aksentyev/tmx-ainalyzer/README.md

# tmx analyzer

DIY-анализатор тримикса для дайвинга: **O2, He, CO2, CO** в одном приборе.
He измеряется акустически — по резонансной частоте закрытой трубки (скорость звука в смеси),
без расходного He-датчика. Мозги — ESP32-C5 на ESP-IDF.

## Статус (2026-10-20)

| Что | Состояние |
|---|---|
| Архитектура, физика, выбор датчиков | решено, см. `docs/decisions.md` |
| Принципиальная схема, распиновка C5, BOM | готово, проверено ревью по даташитам |
| Печатные детали (OpenSCAD) | смоделированы, проверены ревью; ждут замеров реальных модулей |
| Закупка | список готов (`docs/hardware/shopping-list.md`), **ничего не куплено** |
| Прошивка | не начата; требования собраны в `docs/firmware/notes.md` |
| Python-модель смеси (`tools/gasmodel`) | не начата |
| Корпус | печатный лоток v1 на термоклее — решено, не смоделирован |

Дальше: `docs/roadmap.md`.

## Карта репозитория

```
README.md                  ← вы здесь
CLAUDE.md                  правила работы с репо (для Claude и для людей)
docs/
  decisions.md             журнал решений с обоснованиями — почему именно так
  roadmap.md               этапы, что дальше, открытые вопросы
  hardware/
    v1.md                  блок-схема, пневматика, распиновка ESP32-C5, BOM, I2C-адреса
    schematic.md           принципиальная схема по листам, нетлист, бюджет тока, жгуты
    cell.md                акустическая ячейка: зачем так устроена
    layout.md              компоновка корпуса (зонирование) + layout-v1.svg/png
    shopping-list.md       список покупок в две волны
  firmware/
    notes.md               требования к прошивке, вытекшие из железа (I2S, SCD30, ZE15, Кирхгоф…)
hardware/
  scad/                    OpenSCAD-модели печатных деталей, params.scad, render.sh, README.md
  stl/                     (не коммитится) результат render.sh
```

## Ключевые числа

- Трубка Cu Ø25×1.5, L=180, пробки по 15 → L_ак ≈ 145.5 мм. f₁: воздух ≈1180 Гц, He ≈3460 Гц.
- Цель по He: 0.1 % абс. Чувствительность 5.5–12.5 Гц на 1 % He; T газа нужна с ±0.3 °C (0.171 %/°C).
- Пограничный слой Кирхгофа: до ~1 % He систематики без двухточечной калибровки (воздух + He).
- Калибровочные газы в наличии: воздух, Nx50, 100 % O2. He — достать.
- Бюджет железа v1 ≈ $340–420.

## Быстрый старт

```
brew install --cask openscad@snapshot      # стабильный cask отключён, снапшот ок
cd hardware/scad && ./render.sh            # STL + превью всех деталей
```

Перед печатью — пройти по пометкам **ИЗМЕРИТЬ** в `hardware/scad/params.scad`.
