aksentyev/tmx-ainalyzer/docs/hardware/schematic.md

# Принципиальная схема v1 (макет на модулях)

Схема по листам, как будет в KiCad. Все элементы — готовые breakout-модули на макетке/перфоплате,
дискретные компоненты — только обвязка между ними. Имена цепей (нетов) единые по всем листам
и в нетлисте в конце.

Соглашения:
- `+VBAT` — аккумулятор после защиты и выключателя (3.0–4.2 V)
- `+5V` — выход boost
- `+3V3` — выход нашего LDO (периферия). **Не** 3V3 девкита.
- `GND` — общая земля, одна точка звезды на перфоплате у LDO
- Пины девкита — `GPIOn`; пины модулей — по шелкографии модуля

---

## Лист 1 — Питание

```
                 F1 полифьюз 1.5 A
  18650 (+) ──────[====]──────┐
                               │  B+        TP4056 + DW01/FS8205          OUT+ ──┐
  18650 (−) ───────────────────┼─ B−        (модуль с USB-C)              OUT− ──┼─ GND
                               │            IN+/IN− ← USB-C зарядки              │
                               │                                                 │
                               │                        SW1 SPDT            ┌────┘
                               │                       ┌──o  o──── +VBAT ───┤
                               └───────────────────────┘                     │
                                                                             │
  +VBAT ──┬──────────────────────────────────────────────┐                   │
          │                                              │                   │
          │   U1 boost 5 V ≥1 A (MT3608, выставить        │  делитель АКБ:    │
          │      5.2 V — ZE15 требует ≥5.0 V)             │  +VBAT ─ R40 100k ─┬─ GPIO5 (ADC1_CH4)
          │   VIN ── +VBAT        VOUT ── +5V            │          R41 100k ─┤
          │   GND ── GND                                 │          C40 100 nF┤
          │                                              │                    GND
          │
  +5V ──┬─────────┬──────────────┬──────────────────┬───────────────────────────
        │         │              │                  │
        │   C1 220 µF/10 V    U2 AMS1117-3.3    D1 1N5819 ──► пин «5V» девкита
        │   (у MAX98357A)     IN ── +5V          (анод к +5V, катод к девкиту)
        │                     OUT ── +3V3
        │                     GND ── GND
        │                                  C2 100 µF/6.3 V  +3V3 ── GND  (у девкита/перфоплаты)
        │
        └── потребители 5 V: MAX98357A VIN, ZE15 Vin (через D2, лист 6)

  +3V3 потребители: SCD30, TMP117, BMP390, LCD ST7567, подтяжки I2C, лесенка кнопок

  Аналоговая шина (единственное аналоговое место прибора — 12 мВ ячейки на ADS1115):
  +5V ── R42 10 Ω ──┬── U3 LP5907-3.3 (или TPS7A20-3.3) ── +3V3A ── ADS1115 VDD, ICS-43434 VDD
                   C4 10 µF                     C5 1 µF (керамика, у U3)
  RC 10 Ω/10 µF: fc ≈ 1.6 кГц, на 1.2 МГц boost'а −57 dB; падение 0.2 V при 20 mA. Ферритовая бусина
  (600 Ω @ 100 МГц) на 1 МГц даёт лишь 20–50 Ω — здесь бесполезна. Дальше PSRR LP5907 (~40 dB @ 1 МГц,
  80 dB в звуке), шум 6.5 µV RMS — от boost и class-D на ADS1115 ничего не доходит.
  От +3V3 (AMS1117) питать нельзя — LDO нужен запас по входу, поэтому от +5V.
```

Пояснения:
- D1 развязывает нашу +5V с USB VBUS девкита. USB подключён → VBUS 5.0 V > 4.7 V за диодом →
  D1 закрыт, девкит ест USB, периферия — от АКБ. USB отключён → девкит от +5V через D1 (4.7 V на
  входе его LDO — достаточно для 3.3 V).
- Пин «3V3» девкита **ни с чем не соединять**, кроме как измерить.
- Земля — звездой на перфоплате у U2: силовая земля (boost, MAX98357A, ZE15) и земля датчиков
  (ADS1115, ячейка, микрофон) сходятся в одной точке; обратный ток усилителя не течёт через землю ячейки.
- TP4056 без load-sharing → заряжать выключенным (SW1 off).
- Бюджет тока — в конце документа.

---

## Лист 2 — MCU: ESP32-C5-DevKitC-1

Только используемые пины; остальные NC. Нумерация — GPIO, не номер пина гребёнки.

```
                     ┌──────────────────────────────┐
         +5V (за D1)─┤ 5V                       GND ├─ GND
                     │                              │
            SDA ─────┤ GPIO0                  GPIO2 ├───── UART_RX_ZE   (← ZE15 TXD, через R10)
            SCL ─────┤ GPIO1                  GPIO3 ├───── SPI_SCK
        ADC_BTN ─────┤ GPIO4                  GPIO5 ├───── (резерв, ADC1_CH4)
       I2S_BCLK ─────┤ GPIO6                  GPIO7 ├───── NC (JTAG strap)
   PAD_COMP0 рез.────┤ GPIO8                  GPIO9 ├───── PAD_COMP1 резерв
         I2S_WS ─────┤ GPIO10                GPIO11 ├───── UART_TX_ZE   (→ делитель → ZE15 RXD)
         LCD_BL ─────┤ GPIO12                GPIO13 ├───── USB D− (на плате)
                     │                       GPIO14 ├───── USB D+ (на плате)
     I2S_SD_MIC ─────┤ GPIO23                GPIO24 ├───── I2S_SD_AMP
       SPI_MOSI ─────┤ GPIO25                GPIO26 ├───── LCD_DC
        LCD_RST ─────┤ GPIO27                GPIO28 ├───── NC (BOOT)
                     │  USB-C: консоль/прошивка      │
                     └──────────────────────────────┘
```

Последовательные резисторы на I2S (R20–R22, 33 Ω) ставятся у девкита — см. лист 5.

---

## Лист 3 — Шина I2C и датчики на ней

```
  +3V3 ──┬── R1 4.7k ──┐
         └── R2 4.7k ──┼──┐
                       │  │
  GPIO0 ─── SDA ───────┴──┼────┬──────────┬──────────┬──────────┬──────────┐
  GPIO1 ─── SCL ──────────┴────┼────┬─────┼────┬─────┼────┬─────┼────┬─────┼────┐
                               │    │     │    │     │    │     │    │     │    │
                             SDA  SCL   SDA  SCL   SDA  SCL   SDA  SCL   SDA  SCL
                            ┌─────────┐┌─────────┐┌─────────┐┌─────────┐┌─────────┐
                            │ ADS1115 ││  SCD30  ││ TMP117  ││ BMP390  ││ резерв  │
                            │  0x48   ││  0x61   ││  0x49   ││  0x77   ││(ADS1220)│
                            └─────────┘└─────────┘└─────────┘└─────────┘└─────────┘
   питание:                  +3V3A/GND  +3V3/GND   +3V3/GND   +3V3/GND   —
   конфиг:                   ADDR→GND   SEL→GND    ADD0→V+    SDO откр.  —
                             ALERT NC   RDY NC     ALERT NC   CS откр.
                                        PWM NC                (I2C по умолч.)
```

- Скорость шины **100 кГц** (ограничение SCD30), clock stretching включён, таймаут ≥20 мс.
- Подтяжки: перед установкой R1/R2 посчитать, что уже стоит на модулях (ADS1115-модуль обычно
  10k, TMP117/BMP390 брейкауты — 10k). Цель: суммарно 2.2–4.7k.
  Если на модулях набирается ≥3 × 10k, R1/R2 не ставить.
- SCD30 — **опция** (decisions D17); если ставим — на отдельном JST-PH 4, кабель ≤15 см. Без него
  шина свободна от ограничений 100 кГц / clock stretching / no repeated start.
- TMP117 — в пробке B ячейки, кабель 4 жилы ≤15 см, JST-PH 4.
- BMP390 — в камере O2-ячейки.

---

## Лист 4 — O2: гальваническая ячейка → ADS1115

```
   O2-ячейка (R-22D / PSR-11-39-MD, внутри уже нагрузочный резистор и термокомпенсация)
   разъём: JST-PH 2 (на ячейке — Molex, переходник)

     (+) ──── R3 470 Ω ────┬──── AIN0 ┐
                           │          │  ADS1115, PGA ±256 mV (gain 16), диф. AIN0−AIN1
                        C3 220 nF     │  128 SPS, непрерывный режим
                        C0G/плёнка    │
                           │          │
     (−) ──┬─ R4 470 Ω ────┴──── AIN1 ┘
           │
          GND                       AIN2, AIN3 — NC (или резерв под вторую ячейку)
```

- Ячейка даёт +7…+14 mV в воздухе, ~+50…+65 mV в 100 % O2 → в ±256 mV с запасом, LSB 7.8 µV →
  ~0.07 % O2 на отсчёт, с шумом ±2–3 LSB ≈ 0.1–0.2 % без усреднения; усреднение 1 с → 0.05 %.
  Апгрейд — ADS1220 (24 бит, PGA 128): 0.01 %, тот же I2C-разъём. Питание — +3V3A.
- Минус ячейки на GND задаёт синфазный уровень; измерение дифференциальное, чтобы не ловить
  падение на земляных проводах.
- fc фильтра ≈ 770 Гц; суммарно 940 Ω последовательно при входном импедансе 710 kΩ → ошибка
  усиления 0.13 %, уходит в калибровку.
- **Ничего параллельно ячейке не вешать** — нагрузка уже внутри.

---

## Лист 5 — Акустика: I2S full-duplex

```
                       R20 33 Ω
  GPIO6  I2S_BCLK ────[===]────┬──────────────────────────► SCK   ICS-43434 (пробка B)
                               └──────────────────────────► BCLK  MAX98357A
                       R21 33 Ω
  GPIO10 I2S_WS ──────[===]────┬──────────────────────────► WS    ICS-43434
                               └──────────────────────────► LRC   MAX98357A

  GPIO23 I2S_SD_MIC ◄──────────────────────────────────────  SD    ICS-43434
                       R22 33 Ω
  GPIO24 I2S_SD_AMP ──[===]───────────────────────────────►  DIN   MAX98357A

  ICS-43434:  VDD ── +3V3A  GND ── GND   L/R ── GND (левый слот)
              кабель 5 жил ≤15 см, JST-PH 5, витая с GND

  MAX98357A:  VIN ── +5V (C1 220 µF рядом)   GND ── GND
              GAIN ── R23 100k ── VIN   (3 dB; без R23 = 9 dB)
              SD   ── R24 1 MΩ ── VIN   (режим (L+R)/2; на Adafruit-модуле уже стоит)
              +  ── SPK+ ───► динамик Ø20 8 Ω (пробка A), кабель 2 жилы ~25 см, JST-PH 2
              −  ── SPK−
```

- R20–R22 гасят звон на проводах при BCLK 3.072 МГц; ставить у девкита.
- 48 кГц / 32 бит, TX и RX на одном порту (`i2s_new_channel()` с обоими хэндлами).
- Усилитель на +5V — ради запаса по амплитуде; но в прошивке −6 dB, чтобы не спалить динамик.

---

## Лист 6 — CO: ZE15-CO (UART)

Распиновка по даташиту ZE15-CO (2023, 15-pin), совпадает с ZE15: PIN15 Vin 5–12 V; PIN5, PIN14 GND;
PIN7 RXD (0–3.0 V); PIN8 TXD (0–3.0 V); PIN10 DAC 0.4–2 V (не используем); PIN1 — выход 3.0 V
(не используем); **PIN3 — «неисправность сенсора», меандр 1 Гц 10 %** — опционально на свободный
GPIO (12 при BL на +3V3). Прогрев 30 с, отклик ≤30 с (у ZE15 было 3 мин / 60 с).
**Сверить с шелкографией конкретного модуля перед пайкой.**

```
                       D2 1N5819
  +5V ────────────────►|───────── PIN15 Vin        (защита от переполюсовки — своей у ZE15 нет)
                                  PIN5  GND ── GND
                                  PIN14 GND ── GND

                  R11 1k
  GPIO11 UART_TX_ZE ──[===]───┬── PIN7 RXD          V = 3.3·4.7/5.7 = 2.72 V  (вход 0–3.0 V)
                              │
                           R12 4.7k
                              │
                             GND

                  R10 1k
  GPIO2  UART_RX_ZE ◄─[===]────── PIN8 TXD          3.0 V → VIH ESP 2.48 V, ок
```

- 9600 8N1. По умолчанию active upload раз в секунду; при старте переводим в Q&A
  (кадр `FF 01 78 41 00 00 00 00 46`), опрос `FF 01 86 00 00 00 00 00 79`. Протокол — в
  `docs/firmware/notes.md`.
- Vin 5 V минус 0.3 V на D2 = 4.7 V — в диапазоне 5–12 V? **Нет**, 4.7 < 5.0. Варианты:
  (а) Шоттки с малым падением (PMEG2010, ~0.2 V → 4.8 V, всё ещё ниже); (б) убрать D2 и
  защититься механически — ключевой разъём JST-XH; (в) питать ZE15 напрямую с +5V и поднять
  boost до 5.2 V. **Выбор v1: (б) + (в)** — boost выставить 5.2 V, D2 не ставить, разъём с ключом.
  MAX98357A и девкит 5.2 V переносят.

---

## Лист 7 — UI: дисплей и кнопки

```
  LCD ST7567 128×64, SPI 4-wire, трансфлективный (GMG12864-06D / ERC12864, 3.3 V)
      GND ── GND
      VCC ── +3V3
      SCL/SCK ── SPI_SCK   (GPIO3)
      SI/SDA  ── SPI_MOSI  (GPIO25)
      RSE/RST ── LCD_RST   (GPIO27)
      RS/A0   ── LCD_DC    (GPIO26)
      CS      ── GND       (единственный slave; если модуль не терпит — на свободный GPIO)
      LED+/BL ── R33 (по току подсветки модуля, обычно уже стоит) ── LCD_BL (GPIO12, PWM)
      LED−    ── GND
  Названия пинов у модулей гуляют (SCL/SCK, SI/SDA, RSE/RST, RS/A0) — сверять с шелкографией.
  Контраст (регистр EV) зависит от температуры — компенсировать по TMP117/BMP390.

  Кнопки, резисторная лесенка на ADC1_CH3:

  +3V3 ──┬── SW_A ──── 0 Ω ────┐
         ├── SW_B ─── R31 4.7k ─┤
         └── SW_C ─── R32 15k ──┤
                                ├──── GPIO4 ADC_BTN
                   R30 10k ─────┤
                   C30 100 nF ──┤
                               GND

  Уровни: A = 3.3 V (насыщение, норм), B = 2.24 V, C = 1.32 V, ничего = 0 V.
  Пороги в прошивке: >2.8 → A, 1.8–2.8 → B, 0.6–1.8 → C, <0.6 → нет.
  Одновременные нажатия не различаются — не нужны.
```

---

## Нетлист (под будущий KiCad)

| Цепь | Подключения |
|---|---|
| GND | все модули; минус АКБ через TP4056 B−/OUT−; ячейка O2 (−) через R4-узел; ZE15 PIN5, PIN14; LCD CS, LED−; ICS L/R; ADS1115 ADDR; SCD30 SEL; C1, C2, C3-узел, C30, R12, R30 |
| +VBAT | TP4056 OUT+ → SW1 → U1 VIN, R40 |
| VBAT_SENSE | R40/R41 узел; C40; GPIO5 |
| +3V3A | U3 OUT; C5; ADS1115 VDD; ICS-43434 VDD |
| +5V | U1 VOUT; C1; U2 IN; R42 → U3 IN (C4); D1 анод; MAX98357A VIN, R23, R24; ZE15 PIN15 (без D2, см. лист 6) |
| DEVKIT_5V | D1 катод → девкит «5V» |
| +3V3 | U2 OUT; C2; SCD30 VDD; TMP117 V+ и ADD0; BMP390 VIN; LCD VCC; R1, R2; SW_A/B/C |
| SDA | GPIO0; R1; ADS1115, SCD30, TMP117, BMP390 SDA |
| SCL | GPIO1; R2; те же SCL |
| O2_P | ячейка (+) → R3 |
| O2_N | ячейка (−) → R4; → GND |
| ADS_AIN0 | R3 → ADS1115 AIN0; C3 |
| ADS_AIN1 | R4 → ADS1115 AIN1; C3 |
| I2S_BCLK | GPIO6 → R20 → ICS SCK, MAX BCLK |
| I2S_WS | GPIO10 → R21 → ICS WS, MAX LRC |
| I2S_SD_MIC | ICS SD → GPIO23 |
| I2S_SD_AMP | GPIO24 → R22 → MAX DIN |
| SPK+, SPK− | MAX98357A +/− → динамик |
| UART_TX_ZE | GPIO11 → R11 → узел (R12→GND) → ZE15 PIN7 |
| UART_RX_ZE | ZE15 PIN8 → R10 → GPIO2 |
| SPI_SCK | GPIO3 → LCD SCK |
| SPI_MOSI | GPIO25 → LCD SI |
| LCD_DC | GPIO26 → LCD RS/A0 |
| LCD_RST | GPIO27 → LCD RST |
| LCD_BL | GPIO12 → LCD LED+ (через R33) |
| ADC_BTN | GPIO4; R30, C30; SW_A/0 Ω, SW_B/R31, SW_C/R32 |

## Перечень дискретных компонентов схемы

| Поз. | Номинал | Где |
|---|---|---|
| F1 | полифьюз 1.5 A hold | + АКБ |
| U3 | LP5907-3.3 / TPS7A20-3.3 (модуль или SOT-23 на переходнике) | аналоговая шина +3V3A |
| R42 | 10 Ω | +5V → U3, RC-фильтр |
| C4 | 10 µF керамика X7R | вход U3 |
| C5 | 1 µF керамика X7R | выход U3 |
| R40, R41 | 100k | делитель АКБ |
| C40 | 100 nF | узел делителя |
| SW1 | SPDT слайдер ≥1 A | +VBAT |
| D1 | 1N5819 | +5V → девкит 5V |
| C1 | 220 µF / 10 V электролит | +5V у MAX98357A |
| C2 | 100 µF / 6.3 V электролит | +3V3 у перфоплаты |
| C3 | 220 nF C0G/плёнка | ADS1115 AIN0–AIN1 |
| C30 | 100 nF | ADC_BTN |
| R1, R2 | 4.7k (по месту) | I2C подтяжки |
| R3, R4 | 470 Ω | фильтр O2 |
| R10, R11 | 1k | UART ZE15 |
| R12 | 4.7k | делитель на RXD ZE15 |
| R20–R22 | 33 Ω | I2S |
| R23 | 100k | MAX98357A GAIN (3 dB) |
| R24 | 1 MΩ | MAX98357A SD (если нет на модуле) |
| R30 | 10k | подтяжка лесенки вниз |
| R31 | 4.7k | SW_B |
| R32 | 15k | SW_C |
| SW_A–C | тактовые 12 мм | UI |

## Бюджет тока

| Потребитель | Шина | Типично | Пик |
|---|---|---|---|
| ESP32-C5 (BLE активен) | 5V девкита | 80–120 mA | 350 mA |
| LCD ST7567 (1 mA) + подсветка | +3V3 | 1–30 mA | 40 mA |
| SCD30 | +3V3 | 19 mA | 75 mA |
| ADS1115, TMP117, BMP390, ICS-43434 | +3V3/+3V3A | <5 mA | — |
| MAX98357A + динамик 20 мм (чирп, −6 dB) | +5V | 50 mA | 300 mA (импульс) |
| ZE15-CO | +5V | 5 mA | 10 mA |
| **Итого с +5V** (включая LDO) | | ~220 mA | ~730 mA |
| **Со стороны АКБ** (boost КПД 85 %, 3.7 V) | | ~400 mA | ~1.2 A |

18650 2500–3000 mAh → 5–7 ч непрерывной работы, с выключенной подсветкой больше. Полифьюз
1.5 A и boost ≥1 A — с запасом для пиков.

## Разъёмы и жгуты

| Жгут | Разъём | Жилы | Длина | Куда |
|---|---|---|---|---|
| Микрофон | JST-PH 5 | VDD, GND, SCK, WS, SD | ≤15 см | пробка B |
| TMP117 | JST-PH 4 | V+, GND, SDA, SCL | ≤15 см | пробка B |
| Динамик | JST-PH 2 | SPK+, SPK− | ~25 см | пробка A |
| O2-ячейка | JST-PH 2 (+ переходник на Molex ячейки) | +, − | ~10 см | камера O2 |
| BMP390 | JST-PH 4 | VIN, GND, SDA, SCL | ~10 см | камера O2 |
| SCD30 | JST-PH 4 (+ SEL на GND внутри колпака) | VDD, GND, SDA, SCL | ~10 см | колпак SCD30 |
| ZE15 | JST-XH 4 с ключом | Vin, GND, RXD, TXD | ~10 см | колпак ZE15 |
| Дисплей | 8-pin Dupont / пайка | GND, VCC, SCK, SI, RST, RS, CS, BL | ~8 см | крышка |
| Кнопки | 4 провода | +3V3, A, B, C | ~8 см | крышка |
| АКБ | XH 2 | +, − | | холдер |
