aksentyev/tmx-ainalyzer/docs/firmware/notes.md

# Заметки по прошивке (идеи до реализации)

## Критерий стабилизации показаний — по производной, а не по таймеру

Расход через ограничитель-отверстие ∝ давлению в баллоне (4× между 200 и 50 бар) и ~3× выше
для He, чем для воздуха. Время продувки плавает 10–40 с, поэтому фиксированный таймер не работает.

Правило: показание считается стабильным, когда за скользящее окно
- **He/O2 (5 с):** f резонанса ушла меньше чем на ~0.5 Гц, O2 — меньше 0.1 %, T газа — меньше 0.2 °C;
- **CO2 (30 с):** SCD30 имеет τ63 = 20 с — окно длиннее;
- **CO (30–45 с):** ZE15 отклик ≤30 с, прогрев 30 с (первое включение — 5 мин).

Чувствительность f к He зависит от состава: при L_ак = 150 мм ≈ 5.5 Гц/% He около 0 % He и
≈ 12.5 Гц/% около 50 % He. Так что 0.5 Гц — это 0.05–0.09 % He. O2 тоже двигает c:
≈ −1.1 Гц на 1 % O2 → расчёт He обязан брать O2 с ячейки (или ручной ввод, как у Divesoft).

UI показывает «стабилизация…» с индикатором тренда, потом фиксирует результат. Это ещё и
защита от «снял показания, пока гелий не доехал».

## LCD ST7567

Контраст (регистр electronic volume, 0–63) плывёт с температурой: на холоде бледнеет, на жаре
чернеет. Компенсировать линейно по T (TMP117/BMP390), коэффициент подобрать на модуле —
обычно −0.5…−1 единица EV на 10 °C. Подсветка — PWM на GPIO12, автогашение по таймауту и
по яркости снаружи не нужно: трансфлективный читается без подсветки на солнце.

## Консоль и UART

Консоль на USB-Serial/JTAG (`CONFIG_ESP_CONSOLE_USB_SERIAL_JTAG=y`), GPIO11/12 свободны от
консоли. ROM-бутлоадер всё равно печатает в U0TXD (GPIO11) при сбросе — ZE15 на нём битые
кадры игнорирует, но парсер ответов ZE15 должен быть терпим к мусору в первые ~0.5 с.
RX от ZE15 — на GPIO2, **не** на GPIO12 (U0RXD): в download-режиме ROM слушает UART0, а ZE15
в режиме active upload шлёт кадр каждую секунду и может сбить esptool.

## I2S full-duplex

Один контроллер, `i2s_new_channel()` с обоими хэндлами; общие BCLK/WS, одинаковые sample rate и
bits-per-frame у TX и RX. 48 кГц / 32 бит (ICS-43434 отдаёт 24 в 32-битном слоте; MAX98357A ест
16/24/32). DOUT — чирп/шум, DIN — микрофон.

**Оговорка IDF:** full-duplex «не гарантирует синхронной записи/чтения TX и RX, они только
делят клок». Дрейфа нет (один клок), но стартовое смещение между DMA TX и RX — целое число
сэмплов, не фиксированное между запусками. Для резонансного метода (ищем частоты пиков)
безразлично. Для ToF/корреляции (план Б) задержку надо мерить каждый запуск — электрической
петлёй DOUT→DIN или акустическим репером.

MAX98357A в режиме (L+R)/2 (SD_MODE через 1 MΩ): писать одинаковые сэмплы в оба слота, иначе
−6 dB. Амплитуду ограничить −6 dB цифрой (полная шкала при 5 V / 8 Ом ≈ 1.5 Вт — больше
номинала динамика).

## Полоса свипа и распознавание гребёнки

Не следить за одним пиком — свипить широко чирпом/шумом (~1 с), находить все пики, проверять
равный шаг Δf = c/2·L_ак и опознавать номер моды n.

Полоса — **0.5–20 кГц**, не 0.5–8: при L_ак = 150 мм в чистом He моды 3.36 / 6.72 / 10.07 кГц,
в полосе до 8 кГц только два пика, «равный шаг» не проверить. fs = 48 кГц позволяет; срез
MAX98357A 0.47·fs ≈ 22 кГц, ICS-43434 до 20 кГц. Q растёт как √f — высокие моды даже уже.

Поперечные моды: первая (1,0) в трубе Ø22 начинается с 0.586·c/d ≈ 9.1 кГц в воздухе, 13 кГц
в 50 % He, 27 кГц в чистом He. Выше отсечки гребёнка «засоряется». Два средства: микрофон в
центре торца сидит в узле моды (1,0) и почти её не видит; алгоритм ищет **наименьший**
согласованный шаг гребёнки, начиная снизу.

## Пики трубки vs горб динамика

У 20-мм динамика свой резонанс (по даташиту ~500 Гц, Q≈2; с задней камерой 2 мл он уедет к
1–2 кГц) — широкий горб в передаточной функции. Резонансы трубки узкие (Q≈40–80). Искать
пики относительно локального baseline (median filter по спектру), не по абсолютному уровню.

## Пограничный слой Кирхгофа — систематика, зависящая от газа

Термовязкий слой у стенок замедляет волну: Δc/c ≈ −k·(δ_v/R)·(1 + (γ−1)/√Pr), δ_v = √(2ν/ω),
k — коэффициент порядка 0.5–0.7 (теория Кирхгофа для широкой трубы; точное значение в нашей
геометрии уточняется калибровкой). Для R = 11 мм на f₁: воздух ≈ −0.4…−0.6 %, He (ν в 8× выше,
f в 3× выше) ≈ −0.9…−1.2 %. **Если откалибровать L_ак только по воздуху, в чистом He остаётся
≈ −0.5 % по c ≈ 1 % He абсолютной ошибки**, на 50 % He ≈ 0.7 % — выше цели 0.1 %.

Что делать:
1. Двухточечная калибровка: воздух + чистый He (или известный тримикс). Воздух фиксирует
   L_ак, He — коэффициент k.
2. В модели поправка считается из ν, Pr, γ **смеси** — итеративно: оценили состав → поправка →
   уточнили состав; сходится за 2–3 итерации.
3. Работать на высших модах, где поправка ∝ 1/√f меньше: для He брать f₂/f₃, не f₁.

## SCD30 — особенности интерфейса и измерения

- I2C **100 кГц максимум** — вся шина на 100 кГц. Требует clock stretching до 12 мс (раз в
  сутки до 150 мс) — таймаут в драйвере ≥20 мс, одиночные ошибки — ретрай.
- **Не поддерживает repeated start** — не `i2c_master_transmit_receive()`, а write → пауза ≥3 мс →
  read.
- VIH I2C по даташиту 1.75–3.0 V, подтяжки на 3.3 V формально вне спецификации — на практике
  работает, знать.
- ASC по умолчанию **выключен** — не включать никогда: он считает недельный минимум эталоном
  400 ppm, на чистых газах с 0 ppm CO2 уедет. Раз в несколько месяцев — FRC на воздухе (~420 ppm).
- Диапазон 400–10000 ppm, точность ±(30 ppm + 3 %). Порог EN 12021 (500 ppm) — у нижнего края
  с ±45 ppm; показания <400 ppm выдаёт, но вне спецификации. Компенсация давления 700–1200 мбар
  — брать с BMP390.
- **He-матрица**: NDIR зависит от уширения линий фоновым газом (He уширяет слабее N2 → занижение)
  и от теплопроводности (He в 6× выше → тепловой баланс источника/детектора). Количественных
  данных у Sensirion нет — проверять на известной смеси и вводить He-зависимую поправку.

## ZE15-CO

- UART 9600 8N1, 0–500 ppm, 0.1 ppm. Выход 3.0 V TTL, вход 0–3.0 V — на TX от ESP делитель.
- Прогрев 30 с (первое включение 5 мин), отклик ≤30 с, нельзя обдувать струёй — колпак
  диффузионный. Мешающий газ — спирт: не дышать на вход.
- Режим: при старте перевести в Q&A, чтобы не спамил. ZE15 **сам** возвращается в active upload,
  если долго нет запросов — опрашивать регулярно или терпеть кадры.
- PIN3 — выход неисправности сенсора (меандр 1 Гц, 10 %): если заведён на GPIO — считать
  фронты, при наличии показывать «CO sensor fault».

Протокол (одинаков у ZE07 v1.7 и ZE15 2023), кадры 9 байт, контрольная сумма = NOT(byte1+…+byte7) + 1:
- Active upload (раз в 1 с): `FF 04 03 01 HH LL FH FL CS` — CO = (HH·256+LL)·0.1 ppm,
  FH/FL — полная шкала (0x1388 = 5000 → 500 ppm).
- Переключить в Q&A: `FF 01 78 41 00 00 00 00 46`. Обратно в active: `FF 01 78 40 00 00 00 00 47`.
- Запрос в Q&A: `FF 01 86 00 00 00 00 00 79`; ответ: `FF 86 HH LL 00 00 FH FL CS`.
- Пины: 15 Vin (5–12 V), 5/14 GND, 7 RXD (0–3.0 V), 8 TXD, 10 DAC 0.4–2 V. Vin ≥5.0 V — boost на 5.2 V.
