aksentyev/tmx-ainalyzer/docs/hardware/layout.md

# Компоновка v1

Картинка: `layout-v1.svg` (вектор) / `layout-v1.png` — сгенерирована разово из этого файла,
при изменениях править SVG вручную или перерисовать.

Зонирование корпуса, газовый тракт, жгуты, тепловые зоны. Это план под CAD, а не финальные
размеры: всё с допусками ±5 мм, пока не померяны реальные модули.

## Корпус

Одноуровневая компоновка — проще собирать и отлаживать, чем в два этажа. Цена — размер.

- Внутренние размеры: **230 × 125 × 55 мм** (Д × Ш × В). v1 — печатный корпус из двух половин
  (основание + крышка-панель) PETG, или покупной ABS-бокс ближайшего размера с печатной панелью.
- Основание несёт трубку, камеры датчиков, АКБ, силовую электронику, перфоплату, девкит.
- Крышка — дисплей, кнопки.
- Торцевые стенки: слева — вход газа, выхлоп, USB-C зарядки, выключатель; спереди — USB-C девкита.

Длину задаёт ячейка: трубка 180 + фланцы 2×10 = 200 мм, **порты — печатные ёлочки на лагах
фланцев, радиально вперёд** (к центру корпуса), а не осевые — иначе +30 мм на фитинги.
Лаги выступают от края фланца на 15 мм (A) и 22 мм (B) к центру: у торца B они доходят до
Y≈71 — камера O2-ячейки в среднем ряду сдвигается левее/ниже, чтобы не упереться в лаг и
ёлочку. На картинке это пока не отражено — макет на термоклее, поправим по месту.

## Вид сверху (крышка снята), мм

```
 Y
 125 ┌────────────────────────────────────────────────────────────────────────────────┐
     │ ╔════╗                                                                   ╔════╗ │
     │ ║ A  ║═══════════════════ трубка Cu Ø25, L=180 ═══════════════════════════║ B  ║ │  задний ряд
  92 │ ║флан║  ~~~змеевик 6 вит.~~~            ось Y=108                        ║флан║ │  Y 92–125
     │ ╚═╤══╝ X 25–60                                                           ╚══╤═╝ │
     │   │порт A (вниз)                                                            │порт B
  88 ├───┼─────────────────────────────────────────────────────────────────────────┼────┤
     │   │                                                                         │    │
     │ ┌─┴──────────┐  ┌───────────────┐  ┌───────────────┐  ┌─────────────────────┴──┐ │
     │ │ ПИТАНИЕ    │  │ колпак ZE15   │  │ колпак SCD30  │  │ камера O2-ячейки       │ │  средний ряд
  48 │ │ TP4056     │  │ 40×35         │  │ 40×30         │  │ Ø36 × 65, горизонт.    │ │  Y 48–88
     │ │ boost, LDO │  │   ◄──────────────◄───────────────────◄── газ из порта B      │ │
     │ │ SW1        │  │ X 70–110      │  │ X 115–155     │  │ + BMP390 внутри        │ │
     │ └────────────┘  └───────┬───────┘  └───────────────┘  └────────────────────────┘ │
     │  X 10–60               │ выхлоп → левая стенка (Y≈44)                             │
  44 ├────────────────────────┼─────────────────────────────────────────────────────────┤
     │                        │                                                          │
     │ ┌──────────────────┐   │  ┌──────────────────────┐   ┌──────────────────────────┐ │
     │ │ 18650 холдер     │   │  │ ESP32-C5-DevKitC-1   │   │ перфоплата 60×40         │ │  передний ряд
   5 │ │ 78 × 21          │   │  │ 65 × 26, USB-C ─► ▼  │   │ ADS1115, LP5907,         │ │  Y 5–44
     │ │ X 5–85           │   │  │ X 90–160             │   │ MAX98357A, R/C-обвязка   │ │
     │ └──────────────────┘   │  └──────────────────────┘   │ X 165–225                │ │
     │                        │                              └──────────────────────────┘ │
   0 └────────────────────────┴──────────────────────────────────────────────────────────┘
     0        25        50        75       100       125       150       175       200   230  X
```

Левая торцевая стенка (X=0), снизу вверх: выключатель SW1 (Y≈15), USB-C зарядки TP4056 (Y≈30),
**выхлоп** — ёлочка сквозь стенку (Y≈44, на границе среднего и переднего рядов), **вход газа** — ёлочка (Y≈108, напротив змеевика).
Передняя стенка (Y=0): окно под USB-C девкита (X≈125).

Крышка (вид сверху, совпадает по X):
- LCD 128×64 ST7567 (модуль ~55 × 42, померить) над девкитом, X 97–152, Y 5–47 — шлейф 8 см вниз
  к девкиту. Трансфлективный: на солнце подсветку гасить.
- Три кнопки Ø12 над перфоплатой, X 170 / 195 / 220, Y 12 (ниже надписей перфоплаты).
- Над трубкой и датчиками крышка глухая.

## Вид сбоку (сечение по Y=108, трубка), мм

```
 Z
 55 ┌──────────────────────── крышка ───────────────────────────┐
    │                                                            │
    │     ┌────┐  ╭────────────────────────────────────╮  ┌────┐ │
    │     │фл.A│  │   трубка Ø25 + змеевик → Ø33        │  │фл.B│ │   ось Z=24
 24 │     │Ø30 │  │                                     │  │Ø30 │ │
    │     └──┬─┘  ╰────────────────────────────────────╯  └─┬──┘ │
    │        │   ▐P-скоба▌                    ▐P-скоба▌      │    │
    │        │   резина                        резина        │    │
  0 └────────┴───────────────────────────────────────────────┴────┘
```

- Ось трубки на Z=24: снизу 7.5 мм до стенки (P-скоба + втулка), сверху 14 мм до крышки.
- P-скобы на X≈70 и X≈150 — вне змеевика (X 25–60) и не на фланцах.
- Фланцы Ø30 — вертикально помещаются (Z 9–39).

Камера O2 (Ø36 горизонтально) — самый высокий элемент среднего ряда: Z 0–36, запас до крышки
19 мм — туда ложится жгут. SCD30 в колпаке ~20 мм, ZE15 в колпаке ~30 мм (сенсор + плата).

## Газовый тракт по корпусу

```
 DIN-ограничитель на баллоне ─ шланг 1–1.5 м ─▶ ВХОД (левая стенка, Y=108)
   ─▶ силикон 5 см ─▶ змеевик (6 витков на трубке, X 25–60)
   ─▶ силикон 3 см ─▶ порт A (фланец A, радиальный) ─▶ трубка слева направо ─▶ порт B
   ─▶ силикон 6 см ─▶ камера O2 (X 165–225) ─▶ силикон 4 см ─▶ колпак SCD30 (X 115–155)
   ─▶ силикон 4 см ─▶ колпак ZE15 (X 70–110) ─▶ силикон 8 см ─▶ ВЫХЛОП (левая стенка, Y=44)
```

- Все внутренние соединения — силикон 4×6 на печатных ёлочках; в стенке корпуса — переборочные
  ёлочки (bulkhead barb) или напечатанные в лотке; push-in не подходят под силикон.
- Вход и выхлоп на одной стенке: шланги к баллону и выхлоп смотрят в одну сторону, прибор
  можно положить экраном вверх.
- Выхлоп свободный, трубка короткая и без заужений — чтобы в тракте не рос избыток
  (контроль по BMP390 в камере O2).
- Длина силикона в сумме ~30 см → в BOM 3 м хватает с запасом на переделки.
- Дренаж: выхлоп — самая нижняя точка тракта, если прибор стоит на столе; конденсата от
  сухого баллонного газа не будет, а от влажного воздуха при калибровке — ничтожно.

## Тепловые зоны

Единственный температурно-критичный элемент — **трубка**: газ в ней должен быть изотермичен
и равен показанию TMP117. Поэтому:

- **Горячее — подальше от трубки.** AMS1117 (до 0.7 Вт) и boost — в зоне ПИТАНИЕ у левой
  стенки (X 10–60, Y 48–88). От трубки их отделяет ~20 мм воздуха и фланец A. Лучше, чем
  рядом с торцом B, где стоит TMP117.
- **SCD30 греется** (~0.1 Вт) — в среднем ряду, не прилегает к трубке.
- **Змеевик охлаждает/греет трубку** у торца A (до 0.8 Вт на холодном воздухе) — это и есть
  замысел: трубка — тепловой буфер, градиент вдоль неё мал (медь, ~180 г, 400 Вт/м·К), а TMP117 у
  торца B видит газ, прошедший всю трубку.
- АКБ и девкит в переднем ряду — тепловыделение малое, не важно.
- Если при проверке milestone 1 будет виден градиент (f₁ плывёт при прогреве корпуса сильнее,
  чем по TMP117) — второй TMP117 во фланец A и среднее. Место под него есть.

## Акустика и вибрация

- Трубка — только на двух P-скобах через резиновые втулки; фланцы не касаются стенок корпуса.
- Динамик в пробке A — ~200 мм от микрофона по металлу, но через резину на корпус звук почти
  не идёт; внутри трубки — то, что нужно.
- Шум снаружи — только через ВЫХЛОП и ВХОД (Ø3 каналы) — ничтожно.
- Девкит и перфоплата — на стойках M2.5/M3, не на той же пластине, что P-скобы, если корпус
  печатный (разные рёбра).

## Жгуты и их маршруты

| Жгут | Откуда | Куда | Длина | Маршрут |
|---|---|---|---|---|
| Микрофон (5) + TMP117 (4) | пробка B (X≈200, Y≈92) | перфоплата (X 165–225, Y 5–44) | 10–12 см | вниз вдоль правой стенки |
| Динамик (2) | пробка A (X≈15, Y≈92) | MAX98357A на перфоплате | ~25 см | вдоль задней стенки под трубкой |
| O2-ячейка (2) + BMP390 (4) | камера O2 | перфоплата | ~8 см | напрямую |
| SCD30 (4) | колпак SCD30 | перфоплата | ~10 см | |
| ZE15 (4) | колпак ZE15 | девкит/перфоплата | ~12 см | |
| Дисплей (8) | крышка | девкит | ~8 см | петля, чтобы крышка откидывалась |
| Кнопки (4) | крышка | перфоплата | ~8 см | |
| Питание +5V/+3V3/GND | зона ПИТАНИЕ | перфоплата, девкит | ~15 см | вдоль передней стенки под АКБ |
| АКБ | холдер | TP4056 | ~5 см | |

I2S-жилы (BCLK/WS/SD) — витые с GND, 10–12 см, 33 Ω у девкита. Больше 15 см — не надо.

## Что на перфоплате 60×40

ADS1115, LP5907 + RC (аналоговая шина), MAX98357A, R/C-обвязка (фильтр O2, лесенка, I2S-резисторы, делитель ZE15,
C2), I2C-разводка с подтяжками, JST-PH розетки под все жгуты. Девкит — отдельно на своих
стойках, к перфоплате — 12 проводов. В v2 это всё одна плата с модулем ESP32-C5-WROOM.

## Доступ и обслуживание

- O2-ячейка меняется раз в 1–2 года: крышка камеры на 3 саморезах, доступна при снятой крышке
  корпуса без разборки остального.
- Пробки ячейки вынимаются при снятой крышке: трубка на P-скобах, шланги на ёлочках.
- USB-C девкита — через окно в передней стенке: прошивка без вскрытия.
- Зарядка — USB-C TP4056 на левой стенке. Заряжать **выключенным** (нет load-sharing).

## Чеклист перед CAD

- [ ] Померить реальные модули: девкит, TP4056, boost, AMS1117, LCD ST7567, ZE15 с колпаком,
      SCD30 с колпаком, O2-ячейку (Ø, длина с разъёмом), 18650-холдер.
- [ ] Померить фактический Ø канала трубки — под него пробки и O-ring.
- [ ] Решить: печатный корпус или покупной + печатная панель.
- [ ] Камера O2 в коде — **вертикальный стакан Ø37 (с бобышками Ø47), высота 42.5 + разъём**,
      а не «Ø36×65 горизонтально» как на картинке: при высоте корпуса 55 проходит, но место
      в среднем ряду надо пересчитать по месту.
- [ ] Лаги пробок с ёлочками (выступ 15/22 мм к центру корпуса): проверить, что ёлочка не
      упирается в соседний элемент среднего ряда.
