aksentyev/tmx-ainalyzer/docs/hardware/cell.md

# Акустическая ячейка v1

Закрытая с обоих торцов медная трубка; динамик — поршень у торца A, микрофон — в центре
торца B, датчик температуры — в выходной камере. Газ входит за динамиком и обтекает его по
ободу, выходит через камеру с TMP117.

Ревизия 1.2 после ревью SCAD: обжатие O-ring от канала (дно 18.8 при любом зазоре), микрофон
и провода, карман TMP117 с крышкой вместо заливки, колпаки SCD30/ZE07 по даташитам.
Ревизия 1.1 после ревью: исправлены посадка динамика (не влезал в пробку), O-ring (20×2 → 18×2),
положение микрофона (попадал на пробку), введена явная акустическая длина L_ак ≠ длина трубки.

## Размеры, которые надо различать

| | Значение | Примечание |
|---|---|---|
| Трубка, длина | **180 мм** | отрезать от 300; остаток 120 — про запас |
| Пробки, глубина | 15 мм × 2 | |
| **L_ак** (между внутренними торцами) | **150 мм** | всё в расчётах — про неё |
| Канал | Ø22 (измерить фактический, допуск Al-труб ±0.2–0.3) | |
| Объём акустический | ≈57 мл | + задняя камера ~2 мл + выходная ~1.5 мл |

f₁ = c / 2·L_ак: воздух **1144 Гц**, He **3358 Гц** (20 °C). Шаг гребёнки = f₁.
Q по термовязким потерям у стенок: воздух ≈80, He ≈40.

## Сечение

```
     торец A (вход)                                                         торец B (выход)
 ┌────────────┐                                                          ┌────────────┐
─┤ ёлочка     │                  Cu Ø25×1.5, L=180                        │    ёлочка  ├─
 │ ┌──────────┴───────────────────────────────────────────────────────────┴──────────┐ │
 │ │ ▒▒▒▒▒▒▒ │▒▒▒ ┆)))│                                                 │  ┆ ▒▒▒▒▒▒▒▒│ │
 │ │ ▒пробка▒ │зад┆)))│ динамик Ø20 стоит в канале,                  мик ●──┆кам.▒TMP ▒│ │
 │ │ ▒  A   ▒ │кам┆)))│ 1 мм зазор по ободу — газ идёт по нему     отв.Ø1 ┆ ▒ 117 ▒│ │
 │ │ ▒▒▒▒▒▒▒ │▒▒▒ ┆)))│                                                 │  ┆ ▒▒▒▒▒▒▒▒│ │
 │ └──────────┬───────────────────────────────────────────────────────────┬──────────┘ │
 └────────────┘ O-ring 18×2                                    O-ring 18×2 └────────────┘
   |◄─ 15 ─►|◄──────────────────── L_ак = 150 ────────────────────►|◄─ 15 ─►|
                   ~~~~~~~ медный змеевик Ø4 × 50 см, 6 витков, припаян ~~~~~~~~
```

## Трубка

- **Медь T2 Ø25 × 1.5 мм** (твёрдая/полутвёрдая), канал Ø22, отрезать 180 мм ровно, снять заусенцы.
  Медь, а не алюминий (D20): змеевик к ней **паяется** — идеальный тепловой контакт без пасты;
  нет гальванопары Cu–Al на солёной палубе; теплопроводность вдвое выше, масса 180 г против 54 —
  трубка изотермичнее и инерционнее. Размеры канала те же — все модели пробок без изменений.
- Канал измерить штангенциркулем в двух местах — под него печатать пробки и канавки.
- Отверстий в стенке **нет**: микрофон переехал в пробку B (плоская плата на цилиндре Ø25
  отстоит по краям на 0.7 мм — не герметизируется без лыски).
- Опционально 3 отв. Ø2.5/M3 у каждого торца под стопорные винты.

## Пробки (×2) — общее

Модели: `hardware/scad/plug_a.scad`, `plug_b.scad` (параметры в `params.scad`). Что ниже —
замысел; размеры и ориентация печати — в `hardware/scad/README.md`.

Вставные, Ø = (канал − fit) мм, глубина 15 мм, фланец Ø30 × 10 мм. Газовый порт — **печатная
ёлочка Ø6 под силикон 4×6 на лаге**, выступающем от фланца к центру корпуса (пробка A — на
15 мм, пробка B — на 22 мм, там карман TMP117). Фитинги M5 и heat-set вставки не нужны.

**O-ring 18×2** (не 20×2): для поршневого уплотнения в Ø22 при сечении 2.0 **дно канавки
задаётся от канала**: Ø = 22 − 2·0.8·2 = 18.8 при любом зазоре пробки — обжатие 20 %, натяг по ID
4 %. Кольцо 20×2 на таком дне провисает на 6 % и выкручивается. Ширина канавки 2.7; стенка,
нависающая при печати, — с фаской 45°. Фаска 0.5 на ведущей кромке.

Печать PETG/ASA, 5 периметров, 6 слоёв верх/низ, заполнение 30 % — стенки важнее заполнения.
Герметичность пластика при почти нулевом избыточном давлении достаточна — микронатекания
только слегка подмешивают воздух, и это видно по стабилизации.

Почему вставные, а не накидные: внутренний торец задаёт L_ак и стабилен; O-ring работает по
гладкой внутренней стенке.

### Пробка A — динамик + вход

Исходная идея «динамик Ø20 в гнезде внутри пробки Ø21.8» не собирается: стенка гнезда 0.65 мм,
канавка O-ring (дно Ø18.8) пересекается с гнездом. Новая схема — **динамик стоит в самом
канале Ø22 перед пробкой**, пробка его только держит сзади:

- Внутренний торец пробки плоский, в нём задняя камера — выемка Ø14 × 10 мм (1.5 мл + 0.5 мл
  за динамиком ≈ 2 мл; шире нельзя — до дна канавки O-ring должно остаться ≥2 мм), в неё
  выходит канал от ёлочки.
- Акустический торец — диффузор, он на 4.5 мм (бобышки 1.5 + динамик 3) ближе к центру, чем
  торец пробки: **L_ак ≈ 145.5 мм**, f₁(воздух) ≈ 1180 Гц, а не 1144. Константа, калибруется.
- На торце три бобышки высотой 1.5 мм, к ним на 3 капли эпоксидки приклеен динамик **задней
  стороной** (магнитом к пробке, диффузором в трубу). Между динамиком и пробкой — зазор 1.5 мм,
  по ободу динамика в канале — зазор ~1 мм.
- Газ: порт → задняя камера → зазор за динамиком → **по ободу** → труба. Не полагаемся на
  вентиляционные отверстия корзины (у 20-мм майларовых они бывают не всегда); если есть —
  только лучше. Мёртвого объёма нет.
- Пробка с приклеенным динамиком вставляется как одно целое.
- Акустический торец — сам динамик. Щель по ободу — утечка в маленькую камеру, слегка снижает
  Q и сдвигает частоты; константа, калибруется.
- Задняя камера 2 мл не замкнута (связана через обод), но всё равно поднимет f₀ динамика с
  ~500 Гц к 1–2 кГц и уменьшит отдачу внизу. Для детекции пиков некритично; горб динамика в
  передаточной функции будет не там, где у него по даташиту.
- Динамик: Ø20 × 3 мм, 8 Ом, 0.5–1 Вт, майлар (типа PUI AS02008MR, Vansonic 20CS08F):
  f₀≈500 Гц, полоса 0.5–9 кГц. Два — второй про запас.
- Провода (2) — через канал в пробке, залить эпоксидкой.

### Пробка B — микрофон, TMP117, выход

- **Микрофон в центре торца, в газе.** Плата ICS-43434 лежит в углублении 2.6 мм на внутреннем
  торце пробки **плоской стороной (портом) к газу**, компонентами к пробке; две капли эпоксидки
  по углам. Никакого канала между портом и трубой — порт смотрит прямо в пучность давления.
  Провода — через осевое отверстие Ø3 на наружный торец, залить. MEMS-микрофон сухого газа не
  боится. Углубление 10.9×10.9 — под брейкаут ≤10.5×10.5; INMP441 (14×11) не влезает без
  конфликта с канавкой O-ring.
- Центр торца — пучность давления для **всех** продольных мод (в середине трубы нечётные моды
  не видны) и одновременно **узел первой поперечной моды (1,0)** — она начинается с 9.1 кГц в
  воздухе и центральный микрофон её почти не слышит. Это полезно при свипе до 20 кГц.
- Гельмгольц порта Ø1 × 1.5 мм ≈ 16 кГц+ — выше рабочей полосы продольных мод He.
- Выходной канал Ø2.5 от внутреннего торца (вне центра) → радиальный канал Ø3 → **карман
  15.8×12.8×6 в лаге** = газовая камера, открыт с наружного торца: TMP117 breakout лежит на
  дне сенсором вверх, каналы входят **над платой**, провода выходят через паз в стенке, сверху
  приклеивается печатная крышка (`tmp_cover`). Карман **не заливать** — компаунд перекроет
  устья каналов. Из кармана — канал в ёлочку.
- Провода: микрофон 5 (VDD, GND, BCLK, WS, SD; L/R на GND), TMP117 4 (VDD, GND, SDA, SCL).
  Снаружи JST-PH, чтобы ячейка отстёгивалась.
- ICS-43434 у TDK помечен EOL — брать что есть на Ali, запасной вариант INMP441 (та же
  схема включения, 24 бит в 32-битном слоте).

## Змеевик

- Медь Ø4 × 0.5–0.7 мм, 50–70 см. Наматывать прямо на трубку, 6 витков, шаг 5 мм, медленно
  (песок внутри или пружинный трубогиб).
- **Припаять к трубке** мягким сантехническим припоем (Sn-Cu/Sn-Ag) с флюсом, маленькой горелкой:
  прогреть трубку, прихватить витки в нескольких точках, потом пролить шов вдоль. Пайка до
  установки пробок и микрофона. Концы — в силикон 4×6:
  от ограничителя и в порт A.

## Крепление и акустическая развязка

- Две P-скобы 25 мм на резиновых втулках. Жёсткое крепление передаёт в трубу вибрации корпуса
  и звук динамика по металлу.
- Внешний шум попадает внутрь только через порты Ø3 — мало.

## Мелочёвка под ячейку

| Что | Кол | Примечание |
|---|---|---|
| O-ring **18×2** NBR/Viton | 4 | 2 рабочих + запас; если канал по факту ≥22.3 — взять ещё 19×2 |
| O-ring 21×2 | 2 | торцевое уплотнение плеча O2-ячейки в печатной камере (губа до носика 2 мм) |
| ~~Фитинг push-in M5, heat-set~~ | — | не нужны: порты — печатные ёлочки под силикон 4×6 |
| Винты M3×6 стопорные | 6 | опционально |
| Эпоксидка 2-комп. (5-мин + медленная) | 1 | бобышки динамика, микрофон, провода |
| Силикон RTV **нейтральный** | 1 | уксусный ест медь и электронику |
| Припой Sn-Cu/Sn-Ag + флюс для меди | 1+1 | змеевик к трубке |
| Провод 30 AWG силиконовый | 5 цветов | |
| JST-PH 2.0: 2-pin, 4-pin, 5-pin пары | по 2 | |
| Термоусадка 1.5–3 мм | набор | |
| P-скобы 25 мм + резиновые втулки | 2 | |
| Шланг силикон 4×6 | 0.5 м | внутренняя разводка |

## План проверки ячейки без газов (milestone 1)

1. Собрать трубку, пробки, динамик, микрофон, TMP117. Без змеевика и без O2-ячейки.
2. На воздухе: свип 0.5–20 кГц → гребёнка с шагом ≈1144 Гц (при 20 °C; пересчитать на
   фактическую T и L_ак). Выше 9 кГц ждать лишние пики поперечных мод — проверить, что
   центральный микрофон их давит. Оценить Q (ожидание ~80) и SNR.
3. Нагреть/остудить трубку на 10 °C: f₁ должна идти 0.171 %/°C по TMP117.
4. Повторяемость f₁ на одном месте за 10 мин: цель <0.5 Гц.
5. Дунуть в порт — убедиться, что поток не сдвигает f.
Только после этого — He.
