aksentyev/tmx-ainalyzer/docs/decisions.md

# Журнал решений

Что решено, почему, и что отвергнуто. Пересматривать только при новых фактах.
Даты — когда решение принято. Подробности и расчёты — в файлах, на которые есть ссылки.

---

### D1. He измеряется акустически, по скорости звука — 2026-10-19

**Альтернативы:** MEMS-датчик теплопроводности (SGX MTCS2601, Xensor TCG3880) — покупной,
простой, но расходник с ресурсом 5–10 лет, нелинейная калибровка (Вассильева), чувствителен
к влажности и CO2. Акустика — так делает Divesoft He/O2: без расходника, почти линейно по He
при известном O2.
**Решение:** акустика. O2 с гальванической ячейки входит в расчёт He (c² = γRT/M смеси).
**Следствия:** нужна температура газа ±0.3 °C (0.171 %/°C) и учёт влажности при калибровке
по воздуху.

### D2. Резонанс закрытой трубки в слышимом диапазоне, не ToF и не ультразвук — 2026-10-19

**Альтернативы:** ToF 40 кГц (компактно, но цикловая неоднозначность на высокодобротных
пьезо, амплитуда зависит от газа, многомодовость в трубке шире 5 мм); ToF 2 кГц с чирпом как
у Divesoft (надёжно, но база 800 мм).
**Решение:** мерить резонансные частоты f_n = n·c/2L закрытой трубки: свип чирпом 0.5–20 кГц,
поиск гребёнки, фит пиков. Прецизионный тайминг не нужен, задержки трансдьюсеров и амплитуда
не влияют. Q≈40–80.
**Следствия:** надо распознавать номер моды (гребёнка в He в 3× шире); поперечные моды
выше 9 кГц в воздухе — микрофон в центре торца их давит. Пограничный слой Кирхгофа даёт до
~1 % He систематики → двухточечная калибровка воздух + He, модель поправки по ν, Pr смеси,
работать на высших модах. См. `docs/firmware/notes.md`.

### D3. ESP32-C5 на чистом ESP-IDF — 2026-10-19

**Альтернативы:** C3 (хватает для TC-варианта, мало GPIO, нет компаратора), S3 (два ядра,
зрелая экосистема, нет компаратора), Arduino-core (быстрее стартовать, отстаёт по новым чипам).
**Решение:** C5 (~29 GPIO, 240 МГц, аппаратный компаратор PAD_COMP на GPIO8/9 — резерв под
план Б с ToF, один I2S full-duplex) + ESP-IDF.
**Следствия:** console на USB-Serial/JTAG; strapping-пины проверены по даташиту v1.5
(2, 3, 7, 25–28); распиновка в `docs/hardware/v1.md`.

### D4. Ячейка: трубка Ø25×1.5 (канал 22; материал — см. D20), длина 180, вставные пробки 15 мм, O-ring 18×2 — 2026-10-19/20

**Решение:** закрытая с обоих торцов трубка (нет излучения, выше Q, нет концевых поправок).
Канал Ø22, L_ак = 150 между пробками, фактически ≈145.5 из-за вылета динамика. Пробки
печатные PETG с радиальным O-ring 18×2; **дно канавки задаётся от канала** (18.8) → обжатие
20 % при любом зазоре пробки. Три варианта зазора печатаются сразу с тест-кольцами.
**Отвергнуто:** Ø32 трубка (вдвое дольше продувка), O-ring 20×2 (провисает), печатные резьбы.

### D5. Динамик Ø20 стоит в канале перед пробкой A, газ идёт по ободу — 2026-10-20

**Проблема:** Ø20 в гнезде пробки Ø21.8 — стенки 0.65 мм, канавка пересекает гнездо.
**Решение:** динамик приклеен задней стороной к трём бобышкам на торце пробки, зазор по
ободу ~0.9 мм — через него газ из задней камеры (Ø14×10) идёт в трубу. Нет мёртвого объёма,
нет зависимости от вентотверстий корзины.

### D6. Микрофон в центре торца B, в газе, портом в трубу — 2026-10-20

**Альтернативы:** в стенке трубки через Ø1 (плоская плата на цилиндре — не герметизируется);
за каналом в пробке (канал 23 мм — четвертьволновой резонатор на 3.7 кГц, в полосе).
**Решение:** плата ICS-43434 ≤10.5×10.5 лежит в углублении торца портом в газ. Центр торца —
пучность всех продольных мод и узел поперечной (1,0). MEMS сухого газа не боится.
**Следствие:** INMP441 (14×11) не влезает.

### D7. Термализация: змеевик Cu 50 см на резонаторе, TMP117 в пробке B — 2026-10-19/20

**Факт:** газ с вентиля через DIN-ограничитель дросселируется с 200 бар — Джоуль–Томсон
даёт −30…−50 °C для воздуха/O2 и +10 °C для He.
**Решение:** 6 витков меди Ø4 на трубке, припаяны (NTU≈7.5, остаток <0.05 °C); газ,
резонатор и TMP117 — одна изотермическая система. TMP117 — в кармане-камере пробки B
под печатной крышкой (не заливать: компаунд перекроет каналы).

### D8. Газ — с вентиля баллона через покупной O2-clean DIN-ограничитель — 2026-10-19

**Решение автора.** Следствия: см. D7; расход ∝ давлению в баллоне (4× между 200 и 50 бар)
и ~3× выше для He → критерий стабилизации показаний **по производной** (f, O2, T за 5 с),
не по таймеру. Безопасность: ничего самодельного до ограничителя.

### D9. Порядок тракта — 2026-10-20

змеевик → трубка (A→B) → камера O2 (+BMP390) → колпак SCD30 → колпак ZE07 → выхлоп.
Змеевик первым, чтобы холодный газ не бил ни в резонатор, ни в термокомпенсацию ячейки;
O2 после трубки — газ уже при температуре резонатора. Выход короткий и свободный.

### D10. Набор датчиков — 2026-10-19/20

O2 — гальваническая ячейка (R-22D / PSR-11-39-MD) + ADS1115 (gain 16, диф., RC 470 Ω/220 нФ);
CO2 — SCD30 (NDIR; не SCD4x-фотоакустика и не STC31-теплопроводность — врут в He); ASC не
включать, FRC по воздуху; He-матрица NDIR — проверять на известной смеси. CO — Winsen ZE07-CO
по UART (3.0 V логика → делитель на RXD, Vin ≥5.0 V → boost 5.2 V, прогрев 3–5 мин, не обдувать).
P — BMP390 в камере O2. АКБ — MAX17048.

### D11. Дисплей ST7567 128×64 трансфлективный — 2026-10-20

**Альтернативы:** ST7789 TFT (хуже на солнце, 40–60 мА постоянно), LCD 2004 I2C (отлично на
солнце, но 5 V, нужен конвертер уровней, без графики, 98×60).
**Решение:** ST7567 SPI 3.3 V: читается на солнце без подсветки, 1 мА, графика. Пины те же,
что были под TFT (3/25/26/27/12). Контраст компенсировать по T.

### D12. Питание — 2026-10-20

18650 → полифьюз → TP4056 (+защита) → выключатель → boost **5.2 V** (ZE07 ≥5.0 V) →
{ AMS1117-3.3 1 A для периферии; Шоттки → пин 5V девкита; MAX98357A; ZE07 }.
Шоттки развязывает с USB VBUS: отладка с батареей и USB одновременно. Пин 3V3 девкита не
трогать. Заряжать выключенным (нет load-sharing). AP2112K (600 mA) не хватит.

### D13. Печатные ёлочки вместо фитингов M5, печать PETG у друзей на Bambu — 2026-10-20

Печатные резьбы и heat-set в тонких фланцах ненадёжны; ёлочка Ø5.4 под силикон 4×6 проще
и бесплатна. Проектировать под **одну поездку к принтеру**: тест-кольца + все варианты
пробок в одном задании, уплотнения по цилиндру с O-ring, никаких прессовых посадок.
Корпус v1 — печатный лоток, крепёж на термоклее (трубка — на седловинах и стяжках, к алюминию
термоклей не держит); чистовой вариант позже (кандидат — Hammond 1455Q2201, алюминий 220×120×51).

### D14. Распиновка: UART RX ZE07 на GPIO2, не GPIO12 — 2026-10-20

GPIO12 = U0RXD, в download-режиме ROM слушает UART0, а ZE07 шлёт кадр каждую секунду —
может сбить esptool. GPIO8/9 (PAD_COMP) зарезервированы под план Б.

### D15. Закупка в две волны, O2-ячейка последней — 2026-10-20

Волна 1 (~$100): акустика + MCU — чтобы начать прошивку и ячейку с USB-питанием.
Волна 2: датчики CO2/CO/O2, питание, корпус. O2-ячейка — последней: ресурс тикает с распаковки.

### D16. ZE15-CO вместо ZE07-CO — 2026-10-20 (челлендж коллеги)

По даташитам: диапазон, разрешение 0.1 ppm, UART 3 V, питание 5–12 V, распиновка и протокол —
идентичны; у ZE15 прогрев **30 с** (вместо 3 мин), отклик **≤30 с** (вместо 60), плюс выход
неисправности сенсора на PIN3. Drop-in, принято.

### D17. Канал CO2 — опция, решение после M5 — 2026-10-20 (челлендж коллеги)

Коммерческие тримикс-анализаторы CO2 не меряют: это параметр качества воздуха компрессора, не
смеси; CO2 в баллоне появляется вместе с CO, и опасен из них CO. SCD30 при этом — самое
капризное устройство на I2C (100 кГц на шину, clock stretching до 150 мс, нет repeated start).
Если CO2 оставляем — SCD30 правильный выбор: τ63 20 с против ~2 мин у MH-Z19C/S8.
**Решение:** O2/He/CO — ядро; CO2 решить, когда ядро заработает. BOM и схема сохраняют место.

### D18. Питание аналоговой части, MAX17048, ADS1115 — 2026-10-20 (челлендж коллеги)

- Коллега: «TP4056 зашумит акустику, лучше LM317». TP4056 — линейный заряд, не шумит; шумят
  boost (1.2 МГц) и class-D (300 кГц) — вне полосы. LM317 от 18650 невозможен (dropout 1.5–2 В),
  от 5 В — хуже AMS1117. Но интуиция верна: единственное аналоговое место — 12 мВ ячейки на
  ADS1115 (LSB 7.8 мкВ). **Принято:** отдельная шина +3V3A от +5V через RC 10 Ω/10 µF и LP5907-3.3
  (6.5 мкВ RMS, PSRR 80 дБ) для ADS1115 и микрофона; звезда земли. He, CO, T, P, CO2 приходят
  цифрой — внутренний АЦП ESP только на кнопки и делитель АКБ.
- **MAX17048 убран** — делитель 100k/100k на GPIO5 достаточно для прибора, заряжаемого между
  погружениями.
- **MAX98357A оставлен** — у C5 нет ЦАП; PWM даёт гармоники чирпа, возбуждающие соседние
  резонансы; I2S-усилитель делит клок с микрофоном (full-duplex). Один $3 модуль.
- **Один ADS1115 достаточен** — второй дифференциальный канал свободен (вторая ячейка O2).
  Разрешение ~0.1 % O2 без усреднения; апгрейд — ADS1220 (24 бит, 0.01 %).

### D19. Динамик + MEMS-микрофон, не пьезоэлементы — 2026-10-20 (челлендж коллеги)

Резонансному методу нужны **широкополосные** трансдьюсеры: ищем гребёнку пиков трубки (Q≈40–80)
на фоне АЧХ тракта. Пьезодиск — резонатор с Q≈10–30 (пики неотличимы от пиков трубки, резонанс
плывёт с T и зажимом), ниже своего резонанса (у 20-мм диска ~6 кГц) отдача падает ~12 дБ/окт —
на f₁ воздуха 1.2 кГц почти ничего, нужно 20–30 Vpp. Пьезо-приёмник — аналоговый, высокоомный:
зарядовый усилитель + внешний АЦП, тогда как ICS-43434 отдаёт цифру с АЦП внутри и АЧХ ±2 дБ.
Микрофон у нас и так не магнитный (MEMS); магнит динамика ни на что не влияет.
Верное зерно: катушка динамика греется, а работает в 100 % O2 при 1 атм — ограничение
амплитуды в прошивке (−6 дБ, короткие чирпы, средняя мощность десятки мВт) — ещё и мера
безопасности. Пьезо уместен в плане Б (ToF 40 кГц через PAD_COMP на GPIO8/9), см. D2, D3.

### D20. Трубка резонатора — медь T2 Ø25×1.5, не алюминий — 2026-10-20 (вопрос коллеги)

Повод — гальванопара Cu-змеевик / Al-трубка (~0.5 В, алюминий анод) в солёном конденсате на
палубе; термопаста изолирует неравномерно. Но медь выигрывает и без этого: змеевик **паяется**
к трубке (идеальный тепловой контакт вместо пасты и скотча), теплопроводность 400 против 200,
масса 180 г против 54 (сдвиг T за замер 0.35 вместо 0.5 °C), патина вместо питтинга.
Размер **25×1.5 → канал 22** сохраняет все модели и проверки пробок; запасной вариант 26×2.
Не 25×1 (канал 23 — O-ring 18×2 не сядет) и не 24×1 (стенка 1 мм — тонко под горелку).
Трубка твёрдая/полутвёрдая (круглее); змеевик Ø4 — отожжённый (чтобы намотать).
