aksentyev/tmx-ainalyzer/docs/roadmap.md

# Roadmap и открытые вопросы

## Этапы

| # | Этап | Статус | Критерий готовности |
|---|---|---|---|
| M0 | Железо на бумаге: схема, пины, BOM, ячейка, печатные детали | **готово** (2026-10-20) | два ревью пройдены, правки внесены |
| M1 | Закупка волны 1, замеры модулей, печать тест-колец и пробок | ждёт посылок | `params.scad` без пометок ИЗМЕРИТЬ; пробка села в трубку с O-ring |
| M2 | `tools/gasmodel` — Python-модель смеси | не начат | c(T, O2, He, RH) + Кирхгоф + резонатор; бюджет ошибок; калибровочная таблица под воздух/Nx50/O2/He; тесты |
| M3 | Прошивка, скелет: I2S full-duplex, чирп, FFT/Goertzel, поиск гребёнки, фит пиков; хост-тесты DSP на clang | не начат | на воздухе в комнате видна гребёнка ≈1180 Гц, Q≈80, повторяемость f₁ <0.5 Гц за 10 мин |
| M4 | Ячейка без газов (milestone 1 из `cell.md`): T-зависимость 0.171 %/°C, поток не сдвигает f | не начат | |
| M5 | O2 + He: ADS1115, калибровка воздух/O2, He по модели; проверка на Nx50, O2, чистом He | не начат | He на чистом He в пределах 0.5 % после двухточечной калибровки |
| M6 | CO + питание от АКБ + LCD + UI (стабилизация по производной); CO2 (SCD30) — если решим оставить (D17) | не начат | |
| M7 | Лоток-корпус, сборка на термоклее, валидация против коммерческого анализатора | не начат | |
| M8 | v2: чистовой корпус, своя плата с ESP32-C5-WROOM, load-sharing, точёные заглушки | потом | |

## Что делать дальше (в любом порядке, пока едут посылки)

1. **M2 `tools/gasmodel`** — чистый Python 3.9 без numpy (его нет в системе), `unittest`.
   Свойства He/O2/N2/Ar/H2O/CO2 (M, Cp, μ, κ), смешение (Уилки / Мэйсон–Саксена), c² = γRT/M,
   влажность через Магнуса, поправка Кирхгофа с коэффициентом k как параметром, резонатор
   f_n = n·c/2L_ак, обратная задача He(f, T, RH, O2) бисекцией, калибровка L_ак (воздух) и k (He).
   Выход: таблицы чувствительности, бюджет ошибок (T ±0.3, RH, O2 ±0.5 %), проверка, что
   калибровка воздух+He убирает систематику на 18/45 и 10/70.
2. **M3 скелет прошивки** — DSP-ядро как портируемый C без IDF (чирп, окно, FFT, медианный
   baseline, поиск пиков, проверка равного шага, параболическая интерполяция), хост-тесты на
   clang с синтетическим сигналом. IDF-обвязка (I2S full-duplex 48 кГц/32 бит, I2C 100 кГц с
   clock stretching, UART ZE15, SPI LCD) — отдельным слоем, когда приедет девкит и будет
   поставлен ESP-IDF (≥5.5 для C5).
3. **Лоток-корпус в SCAD** — после замеров модулей; седловины под трубку Ø33 на X 70/150,
   стойки под девкит, отверстия в левом торце (вход Y=108, выхлоп Y=44, USB-C зарядки, SW1),
   окно USB-C девкита спереди (широкое), крышка с окном 55×42 под LCD и тремя Ø12.5.

## Открытые вопросы

Железо:
- [ ] 12 размеров **ИЗМЕРИТЬ** в `hardware/scad/params.scad` (канал трубки, динамик, платы
      микрофона/TMP117/BMP390, ячейка Ø/высота/носик/Molex, SCD30, EC-сенсор ZE15).
- [ ] Суммарная I2C-подтяжка после получения breakout'ов (цель 2.2–4.7k; лишние 10k выпаять).
- [ ] Порт микрофона на реальном брейкауте — смещение от центра платы (нужно ≤2 мм от оси трубки).
- [ ] Компоновка среднего ряда: камера O2 в коде — вертикальный стакан Ø47×42.5, лаги пробок
      выступают на 15/22 мм; картинка `layout-v1.svg` это не отражает — поправить по месту.
- [ ] Длина носика O2-ячейки (`nose_len`) — в сети нет; померить.
- [ ] Hammond 1455Q2201 как чистовой корпус — проверить внутренние размеры по чертежу.

Физика/прошивка:
- [ ] Коэффициент k поправки Кирхгофа в нашей геометрии (теория 0.5–0.7) — по чистому He.
- [ ] Нужен ли канал CO2 вообще (D17) — решить после M5; если да — SCD30 в He-матрице проверить на известной смеси.
- [ ] Поведение ZE15 в гипоксичных смесях (нужен O2 ≥ ~10 %) — проверить на 10/70.
- [ ] Какой контраст LCD при каких T — подобрать коэффициент на модуле.

Газы:
- [ ] Достать чистый He; желательно известный тримикс (18/45 или 10/70) для проверки середины.

## Как начать новую сессию

1. Прочитать `README.md`, `CLAUDE.md`, этот файл, `docs/decisions.md`.
2. `git pull`, `cd hardware/scad && ./render.sh` — убедиться, что всё рендерится.
3. Спросить автора, что приехало из посылок и какие размеры померяны — от этого зависит,
   M1 (печать) или M2/M3 (код).
