aksentyev/tmx-ainalyzer/docs/hardware/layout-v1.png

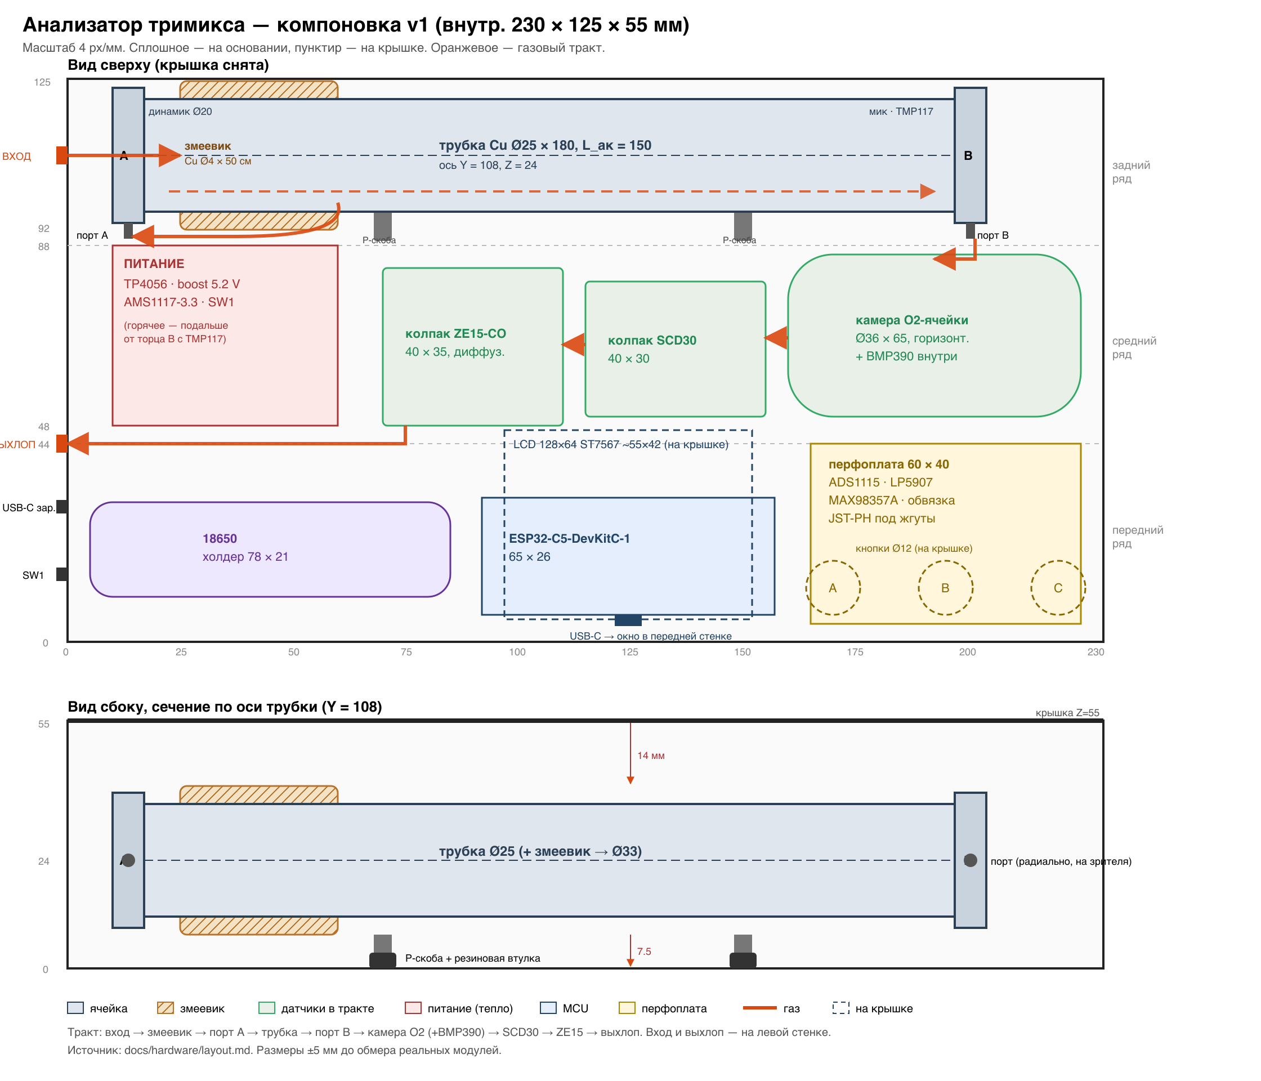
docs/hardware/layout-v1.png
