aksentyev/tmx-ainalyzer/docs/hardware/shopping-list.md

# Список покупок v1

Сводка из `v1.md` (BOM), `cell.md`, `schematic.md` и `hardware/scad/` по состоянию на 2026-10-20.
Волна 1 — то, без чего нельзя начать акустику и прошивку. Волна 2 — независимые датчики и
питание от АКБ, могут приехать позже. Цены ориентировочные.

## Волна 1 — акустика, MCU, ячейка

| # | Что | Кол | Где | Поиск / примечание | ≈ |
|---|---|---|---|---|---|
| 1 | ESP32-C5-DevKitC-1 (N8R8 или N4) | 1 | Mouser / DigiKey / Ali (официальный магазин Espressif) | «ESP32-C5-DevKitC-1» | $12–15 |
| 2 | Микрофон I2S ICS-43434 breakout, плата **≤10.5×10.5 мм** | 1 | Ali | «ICS-43434 I2S module»; INMP441 (14×11) в пробку не влезает — только как запас | $4 |
| 3 | MAX98357A модуль (I2S-усилитель) | 1 | Ali | «MAX98357A I2S amplifier module» | $3 |
| 4 | Динамик Ø20 × 3 мм, 8 Ом, 0.5–1 Вт, майлар | 2 | Ali | «20mm 8 ohm 1W mini speaker» | $3 |
| 5 | TMP117 breakout, плата ≤15×12 мм | 1 | Ali / Adafruit (у Adafruit 25×18 — в карман не влезет) | «TMP117 module» | $8 |
| 6 | Трубка **медь T2 Ø25 × 1.5**, твёрдая/полутвёрдая, 200–300 мм | 1 | Ali | «T2 copper tube 25mm OD 1.5mm wall»; канал 22; отрезать 180. Запасной вариант 26×2 (тоже канал 22). Не 25×1 и не 24×1 | $8 |
| 7 | O-ring 18×2 NBR | 4 | Ali (набор или поштучно) | под пробки; + 19×2 ×2 на случай канала ≥22.3 | $2 |
| 8 | O-ring 21×2 NBR | 2 | Ali | торцевое уплотнение O2-ячейки | $1 |
| 9 | Силиконовая трубка 4×6 мм | 3 м | Ali | «silicone tube 4x6mm» | $4 |
| 10 | Медная трубка Ø4 × 0.5–0.7 мм, **отожжённая (мягкая)** | 1 м | стройка / Ali | змеевик 50–70 см + запас на залом; мягкая — чтобы намотать на Ø25 | $3 |
| 11 | JST-PH 2.0 комплект: 2/4/5-pin разъёмы + провода | набор | Ali | «JST PH 2.0 connector kit with wire» | $5 |
| 12 | Провод силиконовый 30 AWG, 5–6 цветов | набор | Ali | | $5 |
| 13 | Dupont провода M-M / M-F, 20 см | по 40 | Ali | | $3 |
| 14 | Макетная плата 830 точек | 2 | Ali | | $4 |
| 15 | Набор резисторов 1/4 Вт (E12/E24) | набор | Ali | нужны: 10 Ω, 33 Ω ×3, 470 Ω ×2, 1k ×3, 4.7k ×4, 10k ×2, 15k, 100k ×3, 1 MΩ | $5 |
| 16a | Керамика 100 нФ (104), X7R, 50 V, выводная, шаг 2.54/5.08 | 20 | Ali | «104 ceramic capacitor 50V»; антидребезг + развязка | $1 |
| 16b | Керамика 10 мкФ (106), X7R/X5R, 16–25 V, выводная MLCC | 6 | Ali | «10uF 106 MLCC radial 25V»; запас к стабилизаторам | $1 |
| 16c | Плёночный 220 нФ (224), MKT/CBB, 63–100 V, шаг 5 мм | 2 | Ali | «224J 100V CBB capacitor»; фильтр ADS1115 — не керамика | $1 |
| 17a | Электролит 100 мкФ 16 V 105 °C, radial 6.3×11 | 2 | Ali | шина 3.3 V (C2) | $0.5 |
| 17b | Электролит 220 мкФ 16 V 105 °C, radial 8×12 | 2 | Ali | шина 5 V у MAX98357A (C1) | $0.5 |
| 18 | Эпоксидка 5-мин + медленная (30-мин) | 1+1 | хоз. | бобышки динамика, микрофон, заливка карманов | $6 |
| 19 | Силикон RTV **нейтральный** | 1 | хоз. | не уксусный | $4 |
| 20 | Припой сантехнический (Sn97Cu3 / Sn-Ag) + флюс для меди | 1+1 | хоз. | пайка змеевика к трубке | $5 |
| 21 | Газовая горелка (если нет) | 1 | хоз. | для пайки; достаточно маленькой на баллончике | $10 |
| 22 | Термоклей-стержни 11 мм | 10 | хоз. | крепёж макета | $3 |
| 23 | Термоусадка 1.5–3 мм, набор | набор | Ali | | $2 |
| 24 | P-скобы 25 мм + резиновая полоска 2 мм | 2 | стройка | крепление трубки | $2 |

Волна 1 ≈ **$95–100**. Питание на этом этапе — USB девкита; MAX98357A и мик — от 3V3/5V девкита
(усилитель на 5 V с USB, −6 dB в прошивке).

## Волна 2 — остальные газы, питание, корпус

| # | Что | Кол | Где | Поиск / примечание | ≈ |
|---|---|---|---|---|---|
| 25 | **O2-ячейка** Teledyne R-22D или PSR-11-39-MD | 1 | дайв-магазин / Narked at 90 / Oxycheq | **брать последней** — срок жизни тикает с распаковки | $80–110 |
| 26 | **DIN-ограничитель потока для анализатора, O2-clean, 300 бар** | 1 | дайв-магазин (Analox, Vandagraph, Nuvair, Divesoft) | **не DIY** — 200 бар O2 | $40–80 |
| 27 | Sensirion SCD30 | 1 | Mouser / DigiKey / Ali | **опция** — решить после M5 (decisions D17); оригинал, не клон | $45 |
| 28 | Winsen **ZE15-CO** | 1 | Ali (магазин Winsen) | «ZE15-CO Winsen»; не ZE07 — у ZE15 прогрев 30 с и отклик 30 с | $20 |
| 29 | BMP390 breakout, плата ≤15.5×12.5 | 1 | Ali | «BMP390 module» | $6 |
| 30 | ADS1115 модуль | 1 (+1) | Ali | 16-бит, I2C; апгрейд потом — ADS1220 | $3 |
| 31 | LP5907-3.3 (модуль/брейкаут) или TPS7A20-3.3 | 1 | Ali / Mouser | малошумящий LDO для ADS1115 и микрофона; RC-фильтр перед ним — из набора резисторов (10 Ω) и 16b (10 мкФ) | $2 |
| 32 | LCD 128×64 ST7567 SPI 3.3 V, трансфлективный | 1 | Ali | «12864 ST7567 SPI LCD 3.3V» (GMG12864-06D / ERC12864); померить габарит | $5 |
| 33 | Тактовые кнопки 12×12 мм | 5 | Ali | | $2 |
| 34 | 18650 + холдер | 1+1 | | ячейка с защитой или защита на TP4056 | $8 |
| 35 | TP4056 USB-C с защитой (DW01 + FS8205) | 1 (+1) | Ali | «TP4056 type-c protection» | $2 |
| 36 | Boost MT3608 (регулируемый) | 1 (+1) | Ali | выставить **5.2 V** — ZE15 требует ≥5.0 V | $2 |
| 37 | LDO AMS1117-3.3 модуль, 1 A | 1 (+1) | Ali | AP2112K (600 mA) не хватит | $2 |
| 38 | Выключатель SPDT слайдер ≥1 A | 2 | Ali | | $1 |
| 39 | Диод Шоттки 1N5819 | 2 | Ali | +5V → девкит | $1 |
| 40 | Полифьюз 1.5 A hold | 2 | Ali | | $1 |
| 41 | JST-XH 2.54 4-pin с ключом, пара | 2 | Ali | питание/UART ZE15 (нет защиты от переполюсовки) | $1 |
| 42 | Переборочная ёлочка под шланг внутр. 4 мм (bulkhead hose barb, латунь/нейлон, с гайкой) | 2 | Ali | вход/выхлоп сквозь стенку корпуса. **Не push-in**: он держит шланг за наружный Ø и рассчитан на жёсткий PU, силикон 4×6 в нём не держится. Для лотка v1 можно напечатать ёлочку в стенке | $3 |
| 43 | Перфоплата 7×9 см | 2 | Ali | | $2 |
| 44 | Стойки/винты M2.5 и M3 (набор) | набор | Ali | девкит, крышка | $4 |
| 45 | Силиконовый лист 1 мм | 1 | Ali | прокладка колпака ZE15 (или RTV) | $3 |
| 46 | Саморезы M3×10 | 10 | | крышка камеры O2 | $1 |

Волна 2 ≈ **$245–320**. Всего ≈ **$340–420**.

## Печать (у друзей, Bambu, PETG)

Не покупать, принести файл: `hardware/scad/` → `./render.sh` → STL. Сначала тест-кольца и
пробки (после замера трубки и прихода динамика/микрофона/TMP117), потом камера O2 и колпаки
(после прихода ячейки, SCD30, ZE15), коробка — последней.

## Что НЕ нужно (ушло из ранних версий)

- Фитинги push-in M5, heat-set вставки M5 — порты теперь печатные ёлочки.
- ST7789 TFT — заменён на ST7567.
- O-ring 20×2 — не нужны нигде (под пробки 18×2, под O2-ячейку 21×2).
- Шоттки на питание ZE15 — вместо него JST-XH с ключом и boost 5.2 V.
- ZE07-CO — заменён на ZE15-CO (тот же протокол и пины, быстрее).
- MAX17048 — не нужен, АКБ через делитель на GPIO5.

## Калибровочные газы

Есть: воздух, Nx50, 100 % O2. Нужен: чистый He (достать). Хорошо бы: известный тримикс для
проверки середины модели.
