aksentyev/tmx-ainalyzer/(commit log)

2026-10-19 docs: hardware v1 — схема, распиновка C5, BOM, акустическая ячейка, заметки по прошивке
2026-10-19 docs: правки по ревью — ячейка v1.1 (динамик в канале, O-ring 18×2, L_ак=150, мик в торце), тракт, пины ZE07, питание, Кирхгоф, SCD30/ZE07
2026-10-19 docs: принципиальная схема, компоновка v1 + рендер (svg/png); ZE07 — пины и протокол, boost 5.2 V
2026-10-19 docs: дисплей ST7789 TFT → LCD ST7567 128×64 трансфлективный (те же пины, меньше ток, читается на солнце)
2026-10-20 hardware/scad: параметрические модели печатных деталей (тест-кольца, пробки A/B, камера O2, колпаки SCD30/ZE07), render.sh; docs синхронизированы
    [cap_scd30.scad, cap_ze07.scad, lib.scad, o2_chamber.scad, params.scad, plug_a.scad, plug_b.scad, test_rings.scad]
2026-10-20 docs: список покупок v1 в две волны
2026-10-20 hardware/scad: правки по ревью — обжатие O-ring от канала, колпак ZE07 без фланца, коробка SCD30 отверстиями вниз, карман TMP117 с крышкой, камера O2 (носик/канавка/BMP390/бобышки), ёлочки 5.4/2.2, ф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
    [cap_scd30.scad, cap_ze07.scad, lib.scad, o2_chamber.scad, params.scad, plug_a.scad, plug_b.scad, test_rings.scad]
2026-10-20 docs: конденсаторы в списке покупок — конкретные номиналы, типы, напряжения
2026-10-20 docs: README, CLAUDE.md, журнал решений D1–D15, roadmap с открытыми вопросами — для старта следующей итерации с чистой сессии
2026-10-20 docs: по челленджу коллеги — ZE15-CO вместо ZE07, MAX17048 убран (делитель), отдельная малошумящая шина +3V3A (LP5907) для ADS1115 и микрофона, звезда земли, SCD30 → опция (D17), ADS1220 как апгрейд;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
2026-10-20 docs: D19 — динамик + MEMS vs пьезо (челлендж коллеги)
2026-10-20 docs: трубка резонатора — медь T2 Ø25×1.5 вместо алюминия, змеевик паяется (D20)
    [params.scad]
2026-10-20 docs: ввод газа сквозь стенку — переборочная ёлочка вместо push-in (силикон 4×6 в push-in не держится)
2026-10-20 docs: RC 10 Ω/10 µF вместо ферритовой бусины перед LP5907 (бусина на 1.2 МГц почти не работает)
